PetteriAimonen/owon-xdm2041-info/mcu_board/keyboard.md

Keyboard Matrix Layout
===

R/C		| 40 / PB4	| 39 / PB3	| 38 / PA15	| 37 / PA14(*1*)	| 2 / PC13
--------|-----------|-----------|-----------|-----------|-----------
41 / PB5|	__F4__	| __F3__	| __F2__	| __F1__	| __VOLT__
42 / PB6| __F5__	| __LEFT__	| __MATH__	| __SAVE__	| __AMP__
43 / PB7| __DUAL__	| __RANGE__	| __UTILITY__ | __RECORD__ | __OHM__
45 / PB8| __DUAL EXIT__ | __DOWN__ | __UP__	| __RUN/ STOP__ | __CAP__
46 / PB9| __TEMP__	| unused		| __RIGHT__	| __PORT__	| __FREQ__

No pull-ups/downs or decoupling diodes are used.

(*1*) PA14 is shared with SWCLK/JTCK
