PetteriAimonen/owon-xdm2041-info/adc_board/adc_board_bottom.jpg

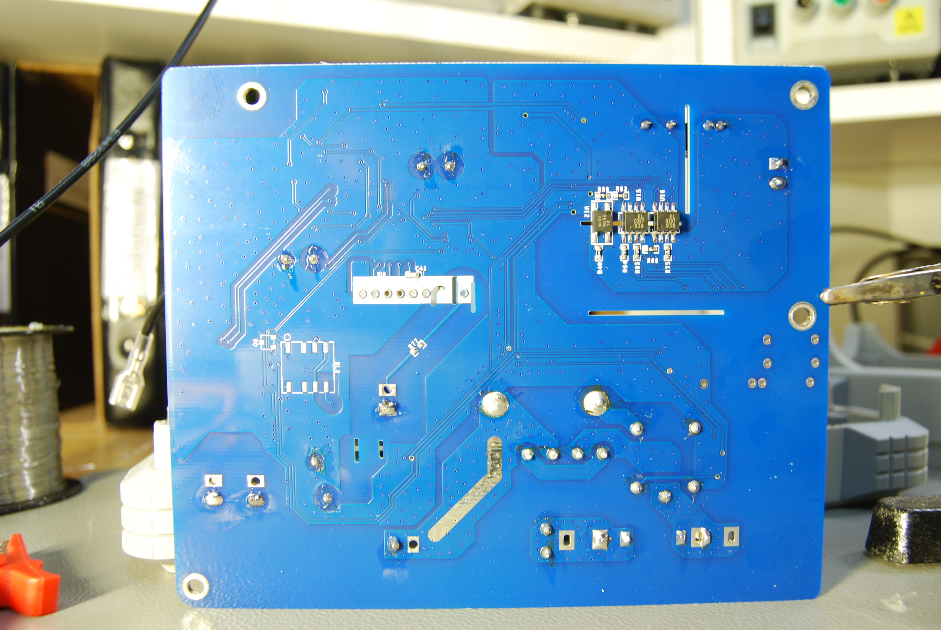
adc_board/adc_board_bottom.jpg
