PetteriAimonen/owon-xdm2041-info/adc_board/adc_board_schematic.png

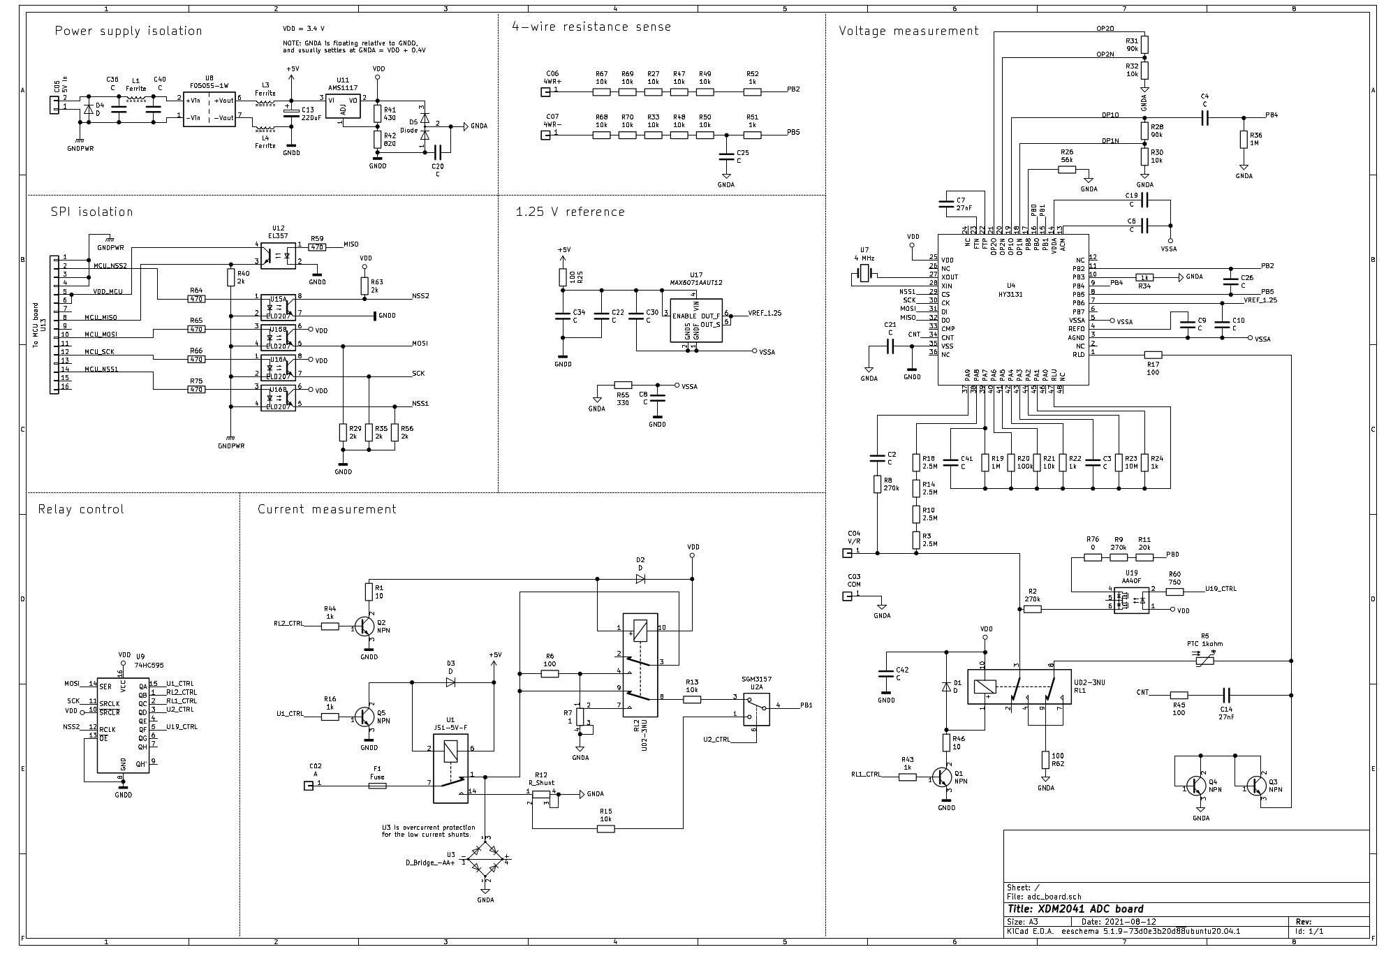
adc_board/adc_board_schematic.png
