PetteriAimonen/owon-xdm2041-info/adc_board/schematic_bgimage.png

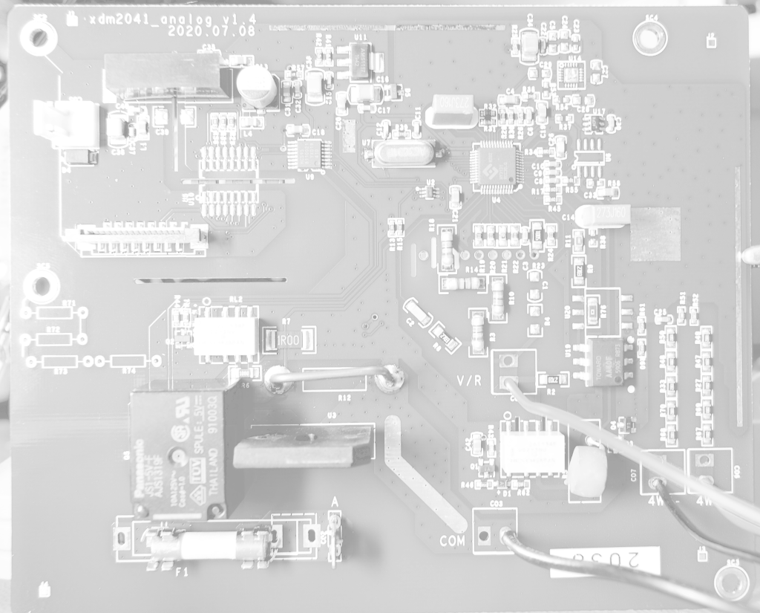
adc_board/schematic_bgimage.png
