PetteriAimonen/owon-xdm2041-info/mcu_board/mcu_board_top.jpg

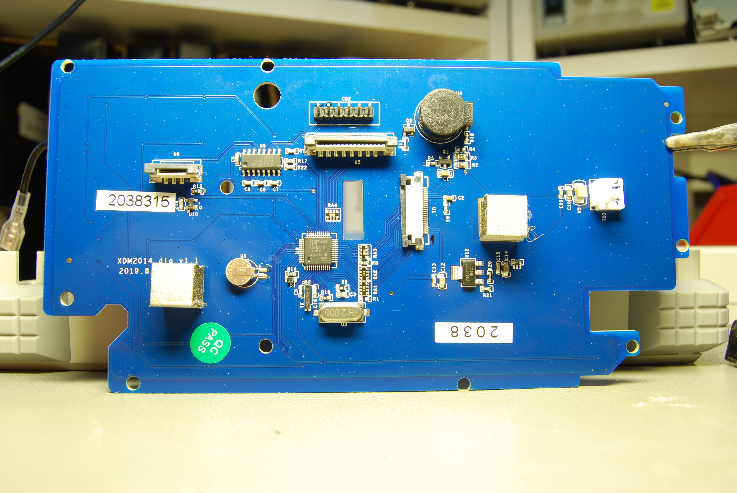
mcu_board/mcu_board_top.jpg
