PetteriAimonen/owon-xdm2041-info/mcu_board/tft_capture_overview.png

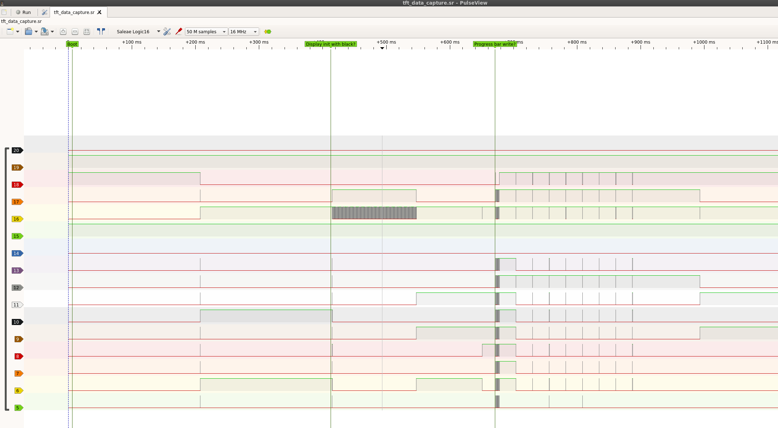
mcu_board/tft_capture_overview.png
