PetteriAimonen/owon-xdm2041-info/adc_board/adc_board.pdf

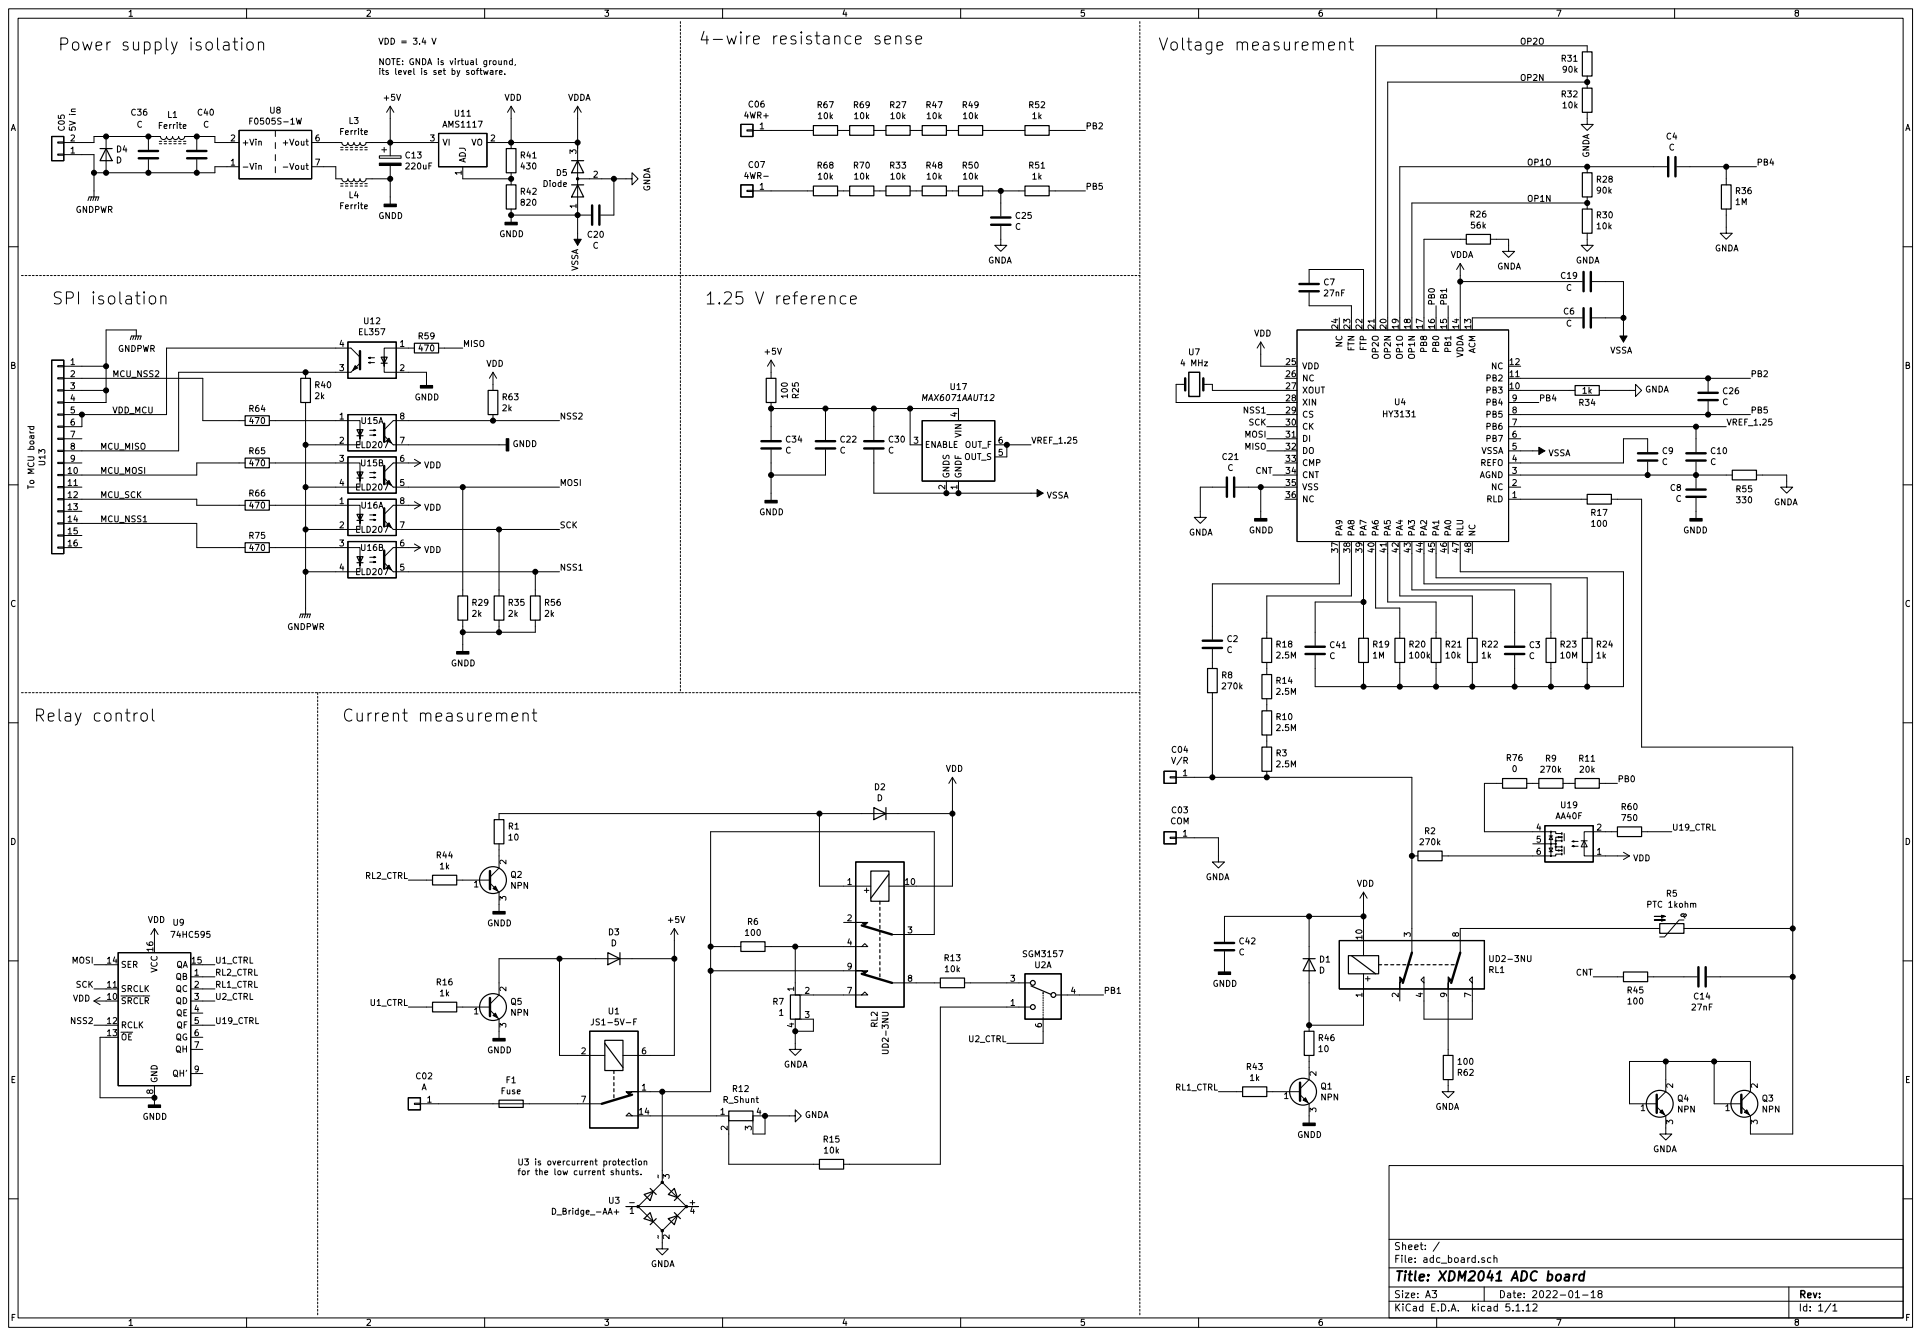
[picture p10: page 1]

SCK Power supply isolation
VDD = 3.4 V Relay control

NOTE: GNDA is virtual ground,
its level is set by software.
+5V GNDD

File: adc_board.sch Sheet: / GNDD

U3 is overcurrent protection
for the low current shunts.

Id: 1/1 Title: XDM2041 ADC board
