PetteriAimonen/owon-xdm2041-info/adc_board/adc_board.sch

## KiCad design adc_board/adc_board.sch (2022-01-18)

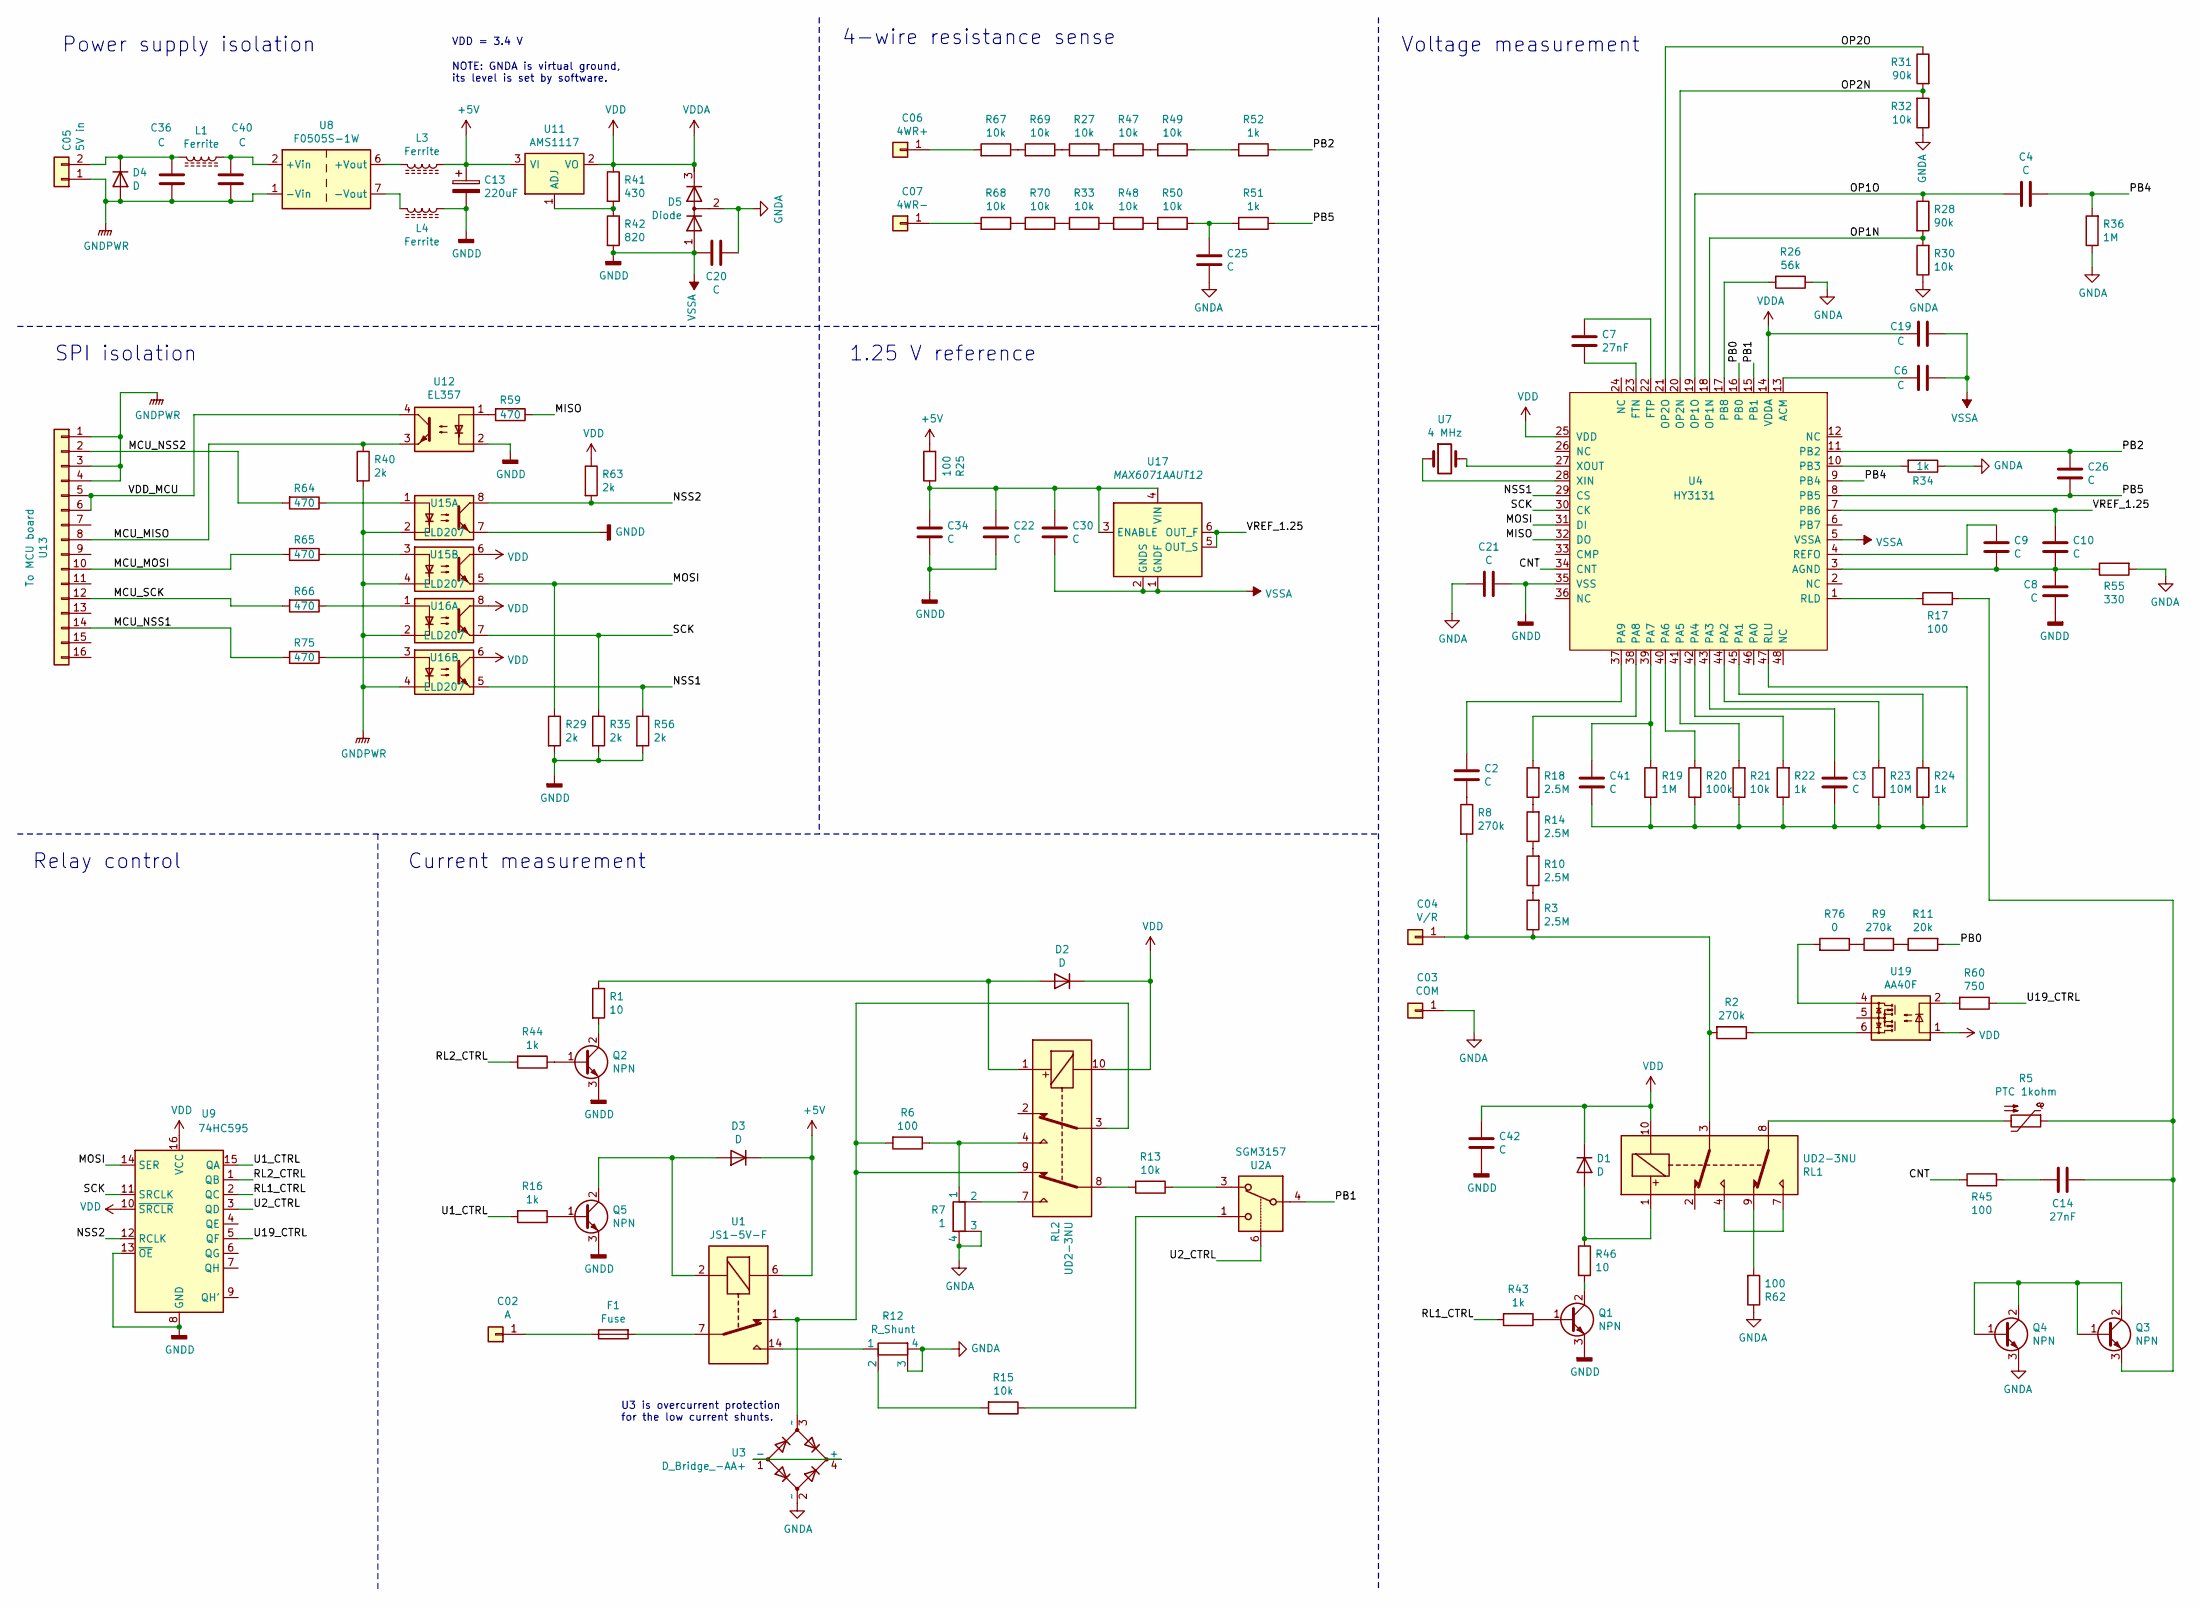
[picture p11: schematic adc_board.sch]

Parts:
C02: A
C2, C3, C4, C6, C8, C9, C10, C19, C20, C21, C22, C25, C26, C30, C34, C36, C40, C41, C42: C
C03: COM
C04: V/R
C05: 5V in
C06: 4WR+
C07: 4WR-
C7, C14: 27nF
C13: 220uF
D1, D2, D3, D4: D
D5: Diode
F1: Fuse
L1, L3, L4: Ferrite
Q1, Q2, Q3, Q4, Q5: NPN
R1, R46: 10
R2, R8, R9: 270k
R3, R10, R14, R18: 2.5M
R5: PTC 1kohm
R6, R17, R25, R45, R62: 100
R7: 1
R11: 20k
R12: R_Shunt
R13, R15, R21, R27, R30, R32, R33, R47, R48, R49, R50, R67, R68, R69, R70: 10k
R16, R22, R24, R34, R43, R44, R51, R52: 1k
R19, R36: 1M
R20: 100k
R23: 10M
R26: 56k
R28, R31: 90k
R29, R35, R40, R56, R63: 2k
R41: 430
R42: 820
R55: 330
R59, R64, R65, R66, R75: 470
R60: 750
R76: 0
RL1, RL2: UD2-3NU; Relay_DPDT_FRT5
U1: JS1-5V-F; Relay_StandexMeder_DIP_LowProfile
U2: SGM3157; SOT-363_SC-70-6
U3: D_Bridge_-AA+
U4: HY3131
U7: 4 MHz
U8: F0505S-1W; Converter_DCDC_XP_POWER-ITXxxxxSA_THT
U9: 74HC595
U11: AMS1117; SOT-223-3_TabPin2
U12: EL357; DIP-4_W7.62mm
U13: To MCU board
U15, U16: ELD207; DIP-8_W7.62mm
U17: MAX6071AAUT12; SOT-23-6
U19: AA40F; DIP-6_W7.62mm

Connections:
+5V: C13.1, D3.1 (K), L3.1, R25.2, U1.6, U11.3 (VI)
CNT: R45.1, U4.34 (CNT)
GNDA: C03.1, C20.1, C21.2, C25.2, D5.2 (common), Q4.3 (E), R7.3, R7.4, R12.3, R12.4, R26.1, R30.1, R32.1, R34.1, R36.1, R55.2, R62.1, U3.2 (~~)
GNDD: C6.2, C8.2, C13.2, C19.1, C20.2, C21.1, C22.2, C30.2, C34.2, C42.2, D5.1 (A), L4.1, Q1.3 (E), Q2.3 (E), Q5.3 (E), R29.2, R35.2, R42.2, R56.2, U4.5 (VSSA), U4.35 (VSS), U9.8 (GND), U9.13 (~OE), U12.2, U15.7, U17.1 (GNDF), U17.2 (GNDS)
GNDPWR: C05.1, C36.2, C40.2, D4.2 (A), R40.2, U8.1 (-Vin), U13.1, U13.3, U13.4, U15.2, U15.4, U16.2, U16.4
MCU_MISO: R40.1, U12.3, U13.8
MCU_MOSI: R65.2, U13.10
MCU_NSS1: R75.2, U13.14
MCU_NSS2: R64.2, U13.2
MCU_SCK: R66.2, U13.12
MISO: R59.1, U4.32 (DO)
MOSI: R29.1, U4.31 (DI), U9.14 (SER), U15.5
NSS1: R56.1, U4.29 (CS), U16.5
NSS2: R63.2, U9.12 (RCLK), U15.8
unnamed: C2.1, U4.37 (PA9)
unnamed: C02.1, F1.1
unnamed: C2.2, R8.1
unnamed: C3.1, U4.43 (PA3)
unnamed: C3.2, C41.2, R19.1, R20.1, R21.1, R22.1, R23.1, R24.1, U4.47 (RLU)
unnamed: C04.1, R2.2, R3.1, R8.2, RL1.3
unnamed: C05.2, C36.1, D4.1 (K), L1.2
unnamed: C6.1, U4.13 (ACM)
unnamed: C06.1, R67.2
unnamed: C7.1, U4.22 (FTP)
unnamed: C07.1, R68.2
unnamed: C7.2, U4.23 (FTN)
unnamed: C9.2, U4.4 (REFO)
unnamed: C8.1, C9.1, C10.1, R55.1, U4.3 (AGND)
unnamed: C14.1, Q3.3 (E), R5.1, R17.2
unnamed: C14.2, R45.2
unnamed: C22.1, C30.1, C34.1, R25.1, U17.3 (ENABLE), U17.4 (VIN)
unnamed: C25.1, R50.1, R51.2
unnamed: C40.1, L1.1, U8.2 (+Vin)
unnamed: C41.1, R19.2, U4.39 (PA7)
unnamed: D1.2 (A), R46.1, RL1.1
unnamed: D2.2 (A), R1.1, RL2.1
unnamed: D3.2 (A), Q5.2 (C), U1.2
unnamed: F1.2, U1.7, U1.8
unnamed: L3.2, U8.6 (+Vout)
unnamed: L4.2, U8.7 (-Vout)
unnamed: Q1.1 (B), R43.1
unnamed: Q1.2 (C), R46.2
unnamed: Q2.1 (B), R44.1
unnamed: Q2.2 (C), R1.2
unnamed: Q3.1 (B), Q3.2 (C), Q4.1 (B), Q4.2 (C)
unnamed: Q5.1 (B), R16.1
unnamed: R2.1, U19.6
unnamed: R5.2, RL1.8
unnamed: R6.1, R7.1, RL2.4
unnamed: R6.2, RL2.3, RL2.9, U1.1, U3.3 (~~)
unnamed: R7.2, RL2.7
unnamed: R3.2, R10.1
unnamed: R10.2, R14.1
unnamed: R9.2, R11.1
unnamed: R12.1, U1.14
unnamed: R12.2, R15.2
unnamed: R13.1, U2.3
unnamed: R13.2, RL2.8
unnamed: R14.2, R18.1
unnamed: R15.1, U2.1
unnamed: R17.1, U4.1 (RLD)
unnamed: R18.2, U4.38 (PA8)
unnamed: R20.2, U4.40 (PA6)
unnamed: R21.2, U4.41 (PA5)
unnamed: R22.2, U4.42 (PA4)
unnamed: R23.2, U4.44 (PA2)
unnamed: R24.2, U4.45 (PA1)
unnamed: R26.2, U4.17 (PB8)
unnamed: R27.1, R47.2
unnamed: R27.2, R69.1
unnamed: R33.1, R48.2
unnamed: R33.2, R70.1
unnamed: R34.2, U4.10 (PB3)
unnamed: R41.2, R42.1, U11.1 (ADJ)
unnamed: R47.1, R49.2
unnamed: R48.1, R50.2
unnamed: R49.1, R52.2
unnamed: R59.2, U12.1
unnamed: R60.2, U19.2
unnamed: R62.2, RL1.9
unnamed: R64.1, U15.1
unnamed: R65.1, U15.3
unnamed: R66.1, U16.1
unnamed: R67.1, R69.2
unnamed: R68.1, R70.2
unnamed: R75.1, U16.3
unnamed: R9.1, R76.1
unnamed: R76.2, U19.4
unnamed: RL1.4, RL1.7
unnamed: U3.1 (-), U3.4 (+)
unnamed: U4.27 (XOUT), U7.2
unnamed: U4.28 (XIN), U7.1
OP1N: R28.2, R30.2, U4.18 (OP1N)
OP1O: C4.2, R28.1, U4.19 (OP1O)
OP2N: R31.2, R32.2, U4.20 (OP2N)
OP2O: R31.1, U4.21 (OP2O)
PB0: R11.2, U4.16 (PB0)
PB1: U2.4, U4.15 (PB1)
PB2: C26.1, R52.1, U4.11 (PB2)
PB4: C4.1, R36.2, U4.9 (PB4)
PB5: C26.2, R51.1, U4.8 (PB5)
RL1_CTRL: R43.2, U9.2 (QC)
RL2_CTRL: R44.2, U9.1 (QB)
SCK: R35.1, U4.30 (CK), U9.11 (SRCLK), U16.7
U1_CTRL: R16.2, U9.15 (QA)
U2_CTRL: U2.6, U9.3 (QD)
U19_CTRL: R60.1, U9.5 (QF)
VDD: C19.2, C42.1, D1.1 (K), D2.1 (K), D5.3 (K), R41.1, R63.1, RL1.10, RL2.10, U4.14 (VDDA), U4.25 (VDD), U9.10 (~SRCLR), U9.16 (VCC), U11.2 (VO), U15.6, U16.6, U16.8, U19.1
VDD_MCU: U12.4, U13.5, U13.6
VREF_1.25: C10.2, U4.7 (PB6), U17.5 (OUT_S), U17.6 (OUT_F)

Notes on the sheet:
VDD = 3.4 V
NOTE: GNDA is virtual ground, its level is set by software.
U3 is overcurrent protection for the low current shunts.
Power supply isolation
SPI isolation
4-wire resistance sense
1.25 V reference
Relay control
Current measurement
Voltage measurement
