PetteriAimonen/owon-xdm2041-info/spi_captures/activate_modes.py

import serial
import time

port = serial.Serial("/dev/ttyUSB1", 115200)

cmds = '''

CONF:VOLT:DC 0.05
CONF:VOLT:DC 0.5
CONF:VOLT:DC 5
CONF:VOLT:DC 50
CONF:VOLT:DC 500
CONF:VOLT:DC 1000

CONF:VOLT:AC 0.5
CONF:VOLT:AC 5
CONF:VOLT:AC 50
CONF:VOLT:AC 500
CONF:VOLT:AC 750

CONF:CURR:DC 0.0005
CONF:CURR:DC 0.005
CONF:CURR:DC 0.05
CONF:CURR:DC 0.5
CONF:CURR:DC 5
CONF:CURR:DC 10

CONF:CURR:AC 0.0005
CONF:CURR:AC 0.005
CONF:CURR:AC 0.05
CONF:CURR:AC 0.5
CONF:CURR:AC 5
CONF:CURR:AC 10

CONF:RES 500
CONF:RES 5E3
CONF:RES 50E3
CONF:RES 500E3
CONF:RES 5E6
CONF:RES 50E6

CONF:RES 500
CONF:FRES
CONF:RES 5E3
CONF:FRES
CONF:RES 50E3
CONF:FRES

CONF:CONT

CONF:DIOD

CONF:CAP 50E-9
CONF:CAP 500E-9
CONF:CAP 5E-6
CONF:CAP 50E-6
CONF:CAP 500E-6
CONF:CAP 5E-3
CONF:CAP 50E-3

CONF:FREQ

CONF:TEMP:RTD KITS90
CONF:TEMP:RTD PT100
'''

for line in cmds.split('\n'):
    line = line.strip()
    if line:
        print(line)
        
        port.write(line.encode('ascii') + b'\r\n')
        port.flush()
        time.sleep(3.0)
