PetteriAimonen/owon-xdm2041-info/(commit log)

2021-08-12 Add MCU board photos
2021-08-12 Added connector U5
2021-08-12 Added USB/RS232 Connector
2021-08-12 Add ADC board photos
2021-08-12 Added TFT Pin 5 comment
2021-08-12 Beginnings of ADC board schematic
    [adc_board.sch]
2021-08-12 More work on ADC board schematics
    [adc_board.sch]
2021-08-13 Map out U2 on ADC board
    [adc_board.sch]
2021-08-13 Map out ADC board digital connections & DGND
    [adc_board.sch]
2021-08-13 Map remaining connections on ADC board
    [adc_board.sch]
2021-08-13 Clean up ADC board schematic
    [adc_board.sch]
2021-08-14 Add MCU board CO2 pinout
2021-08-14 Add dumps of SPI traffic
2021-08-14 Notes about max SPI speed
2021-08-15 Fix mistakes in SPI capture
    [activate_modes.py, annotate.py, annotate_uart.py]
2021-08-22 Add notes about readout/flashing
    [GD32F103.cfg, GD32F103_dump_script.txt]
2022-01-09 Add script to upload calibration data
2022-01-09 Begin resolving calibration constant meaning
2022-01-09 Resolved more calibration constants
2022-01-10 Add calibration backup script
2022-01-18 ADC board schematic: fix GNDA/VSSA mixup
    [adc_board.sch]
2022-01-19 Add scope screenshots for SPI waveform
2022-01-26 Note that BOOT0 button is no longer useful
2022-02-01 Add ADC scaler to calibration constant list
